LuZening/OPA1000/reference/pc-board-rf-deck.jpg

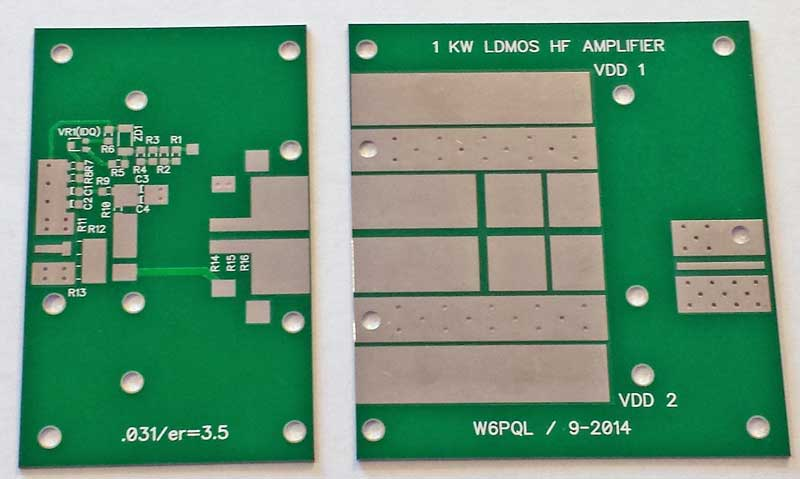
reference/pc-board-rf-deck.jpg
