LuZening/OPA1000/reference/52017sch.jpg

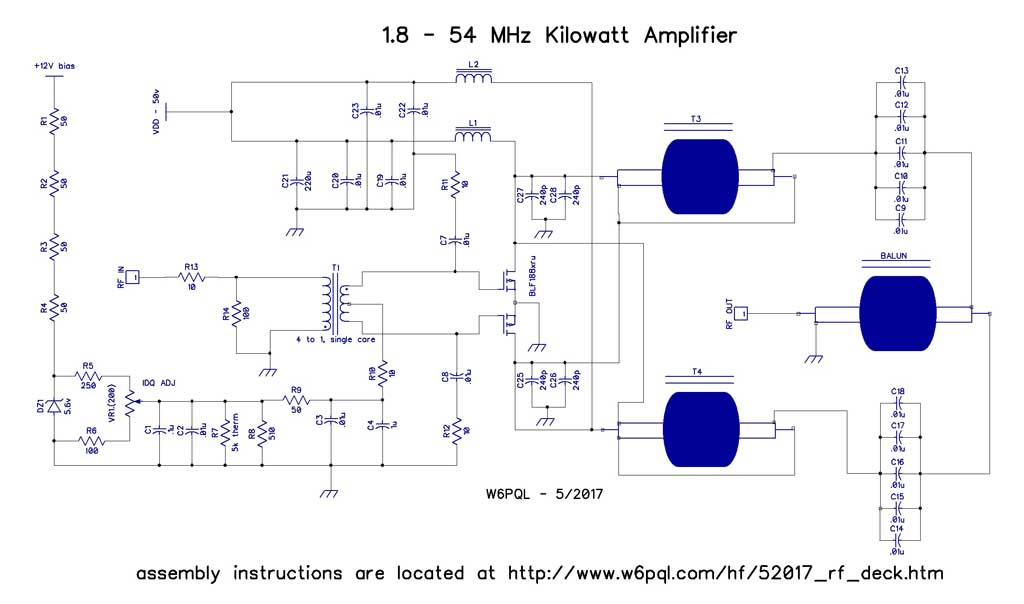
reference/52017sch.jpg
