LuZening/OPA1000/reference/201706schematic.jpg

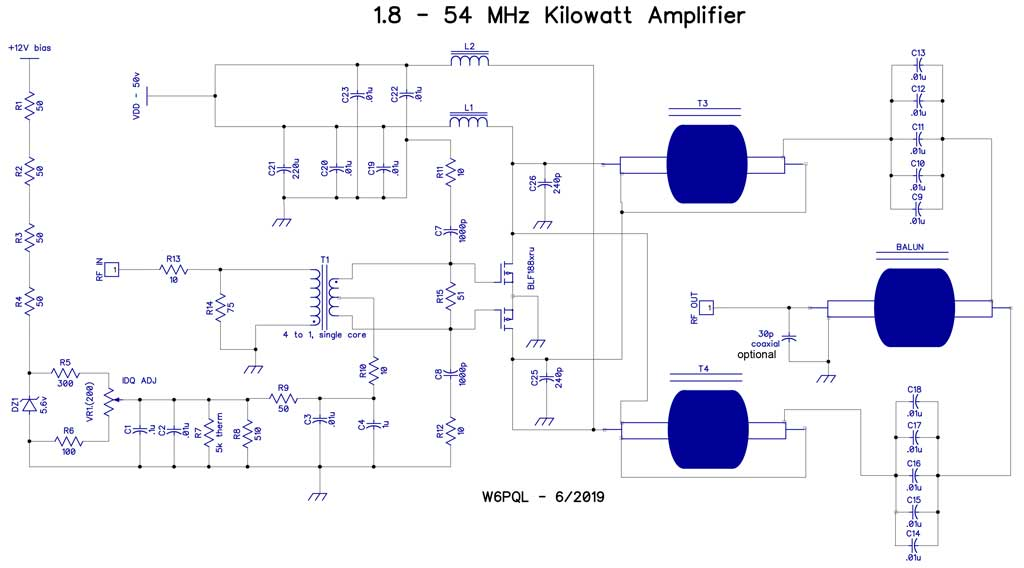
reference/201706schematic.jpg
