LuZening/OPA1000/reference/CAN.png

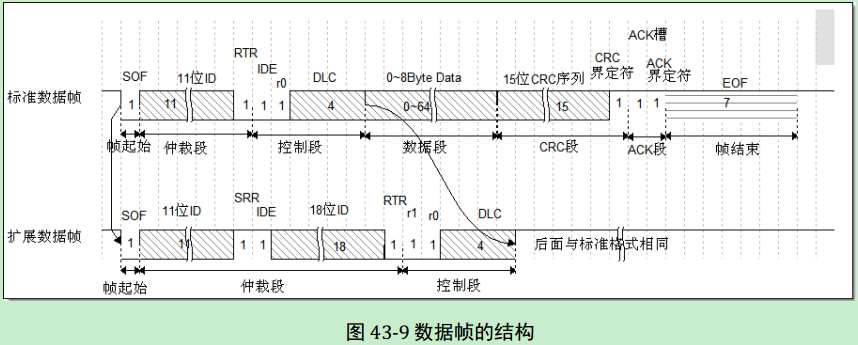
reference/CAN.png
