LuZening/OPA1000/reference/LCD/TB23FU7acbI8KJjy1zdXXbe1VXa_!!23732491.jpg

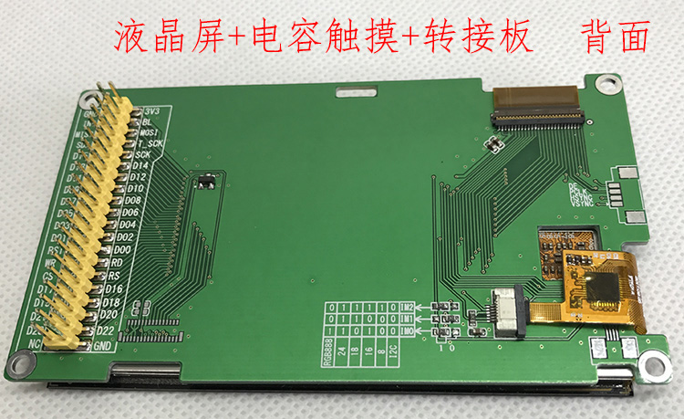
reference/LCD/TB23FU7acbI8KJjy1zdXXbe1VXa_!!23732491.jpg
