LuZening/OPA1000/reference/power.png

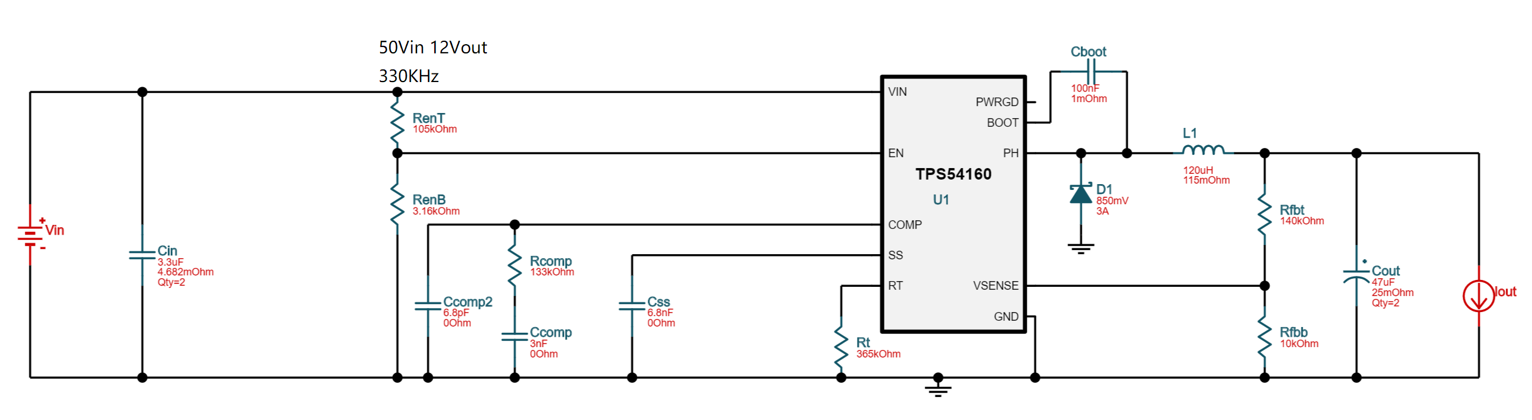
reference/power.png
