LuZening/OPA1000/reference/STM32CAN.png

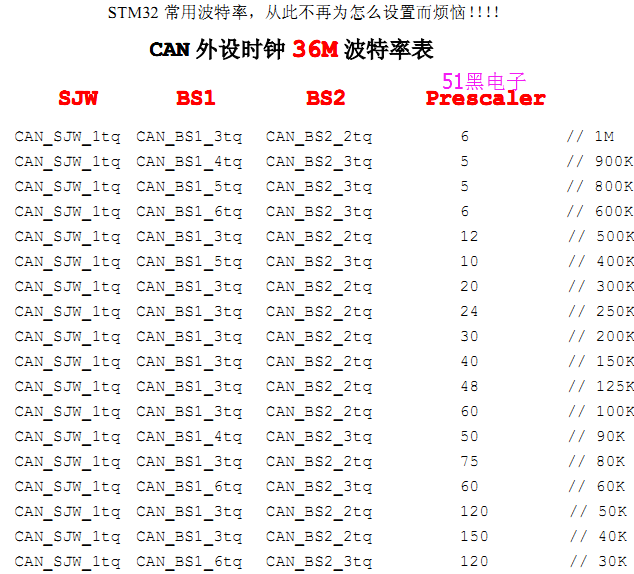
reference/STM32CAN.png
