LuZening/OPA1000/reference/T106-2.jpg

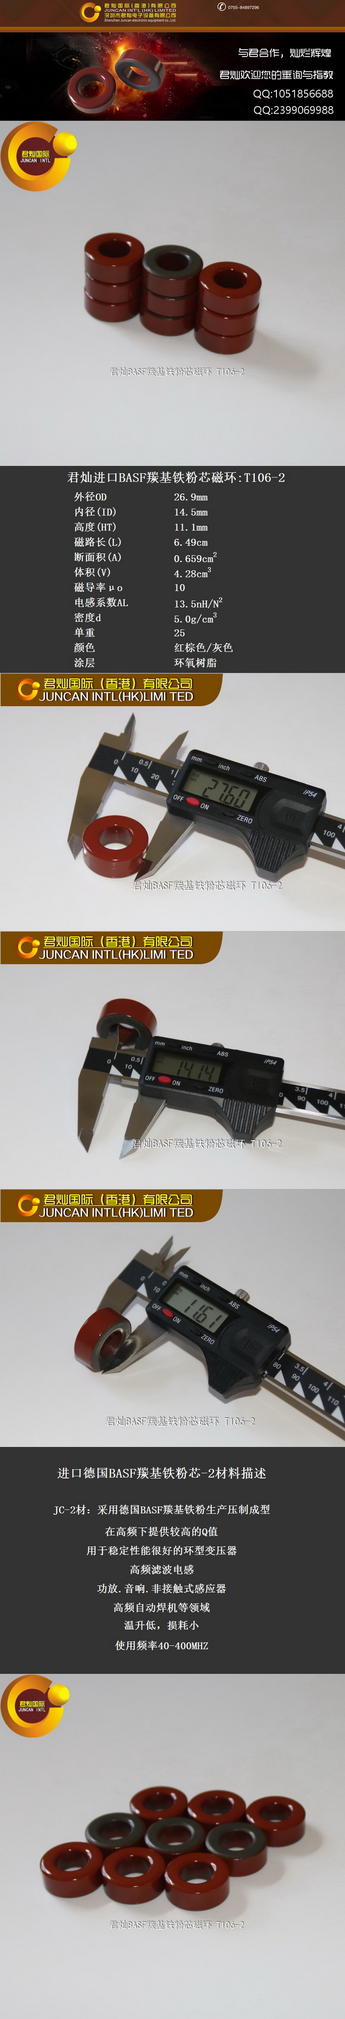
reference/T106-2.jpg
