LuZening/OPA1000/reference/T106-6.png

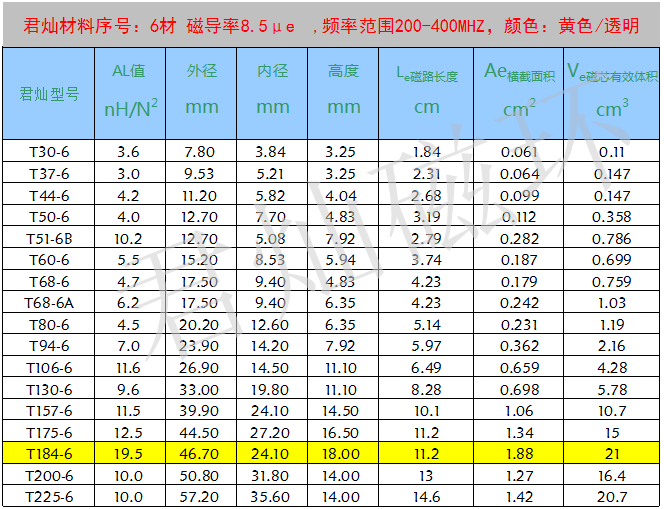
reference/T106-6.png
