LuZening/OPA1000/reference/T130-2.jpg

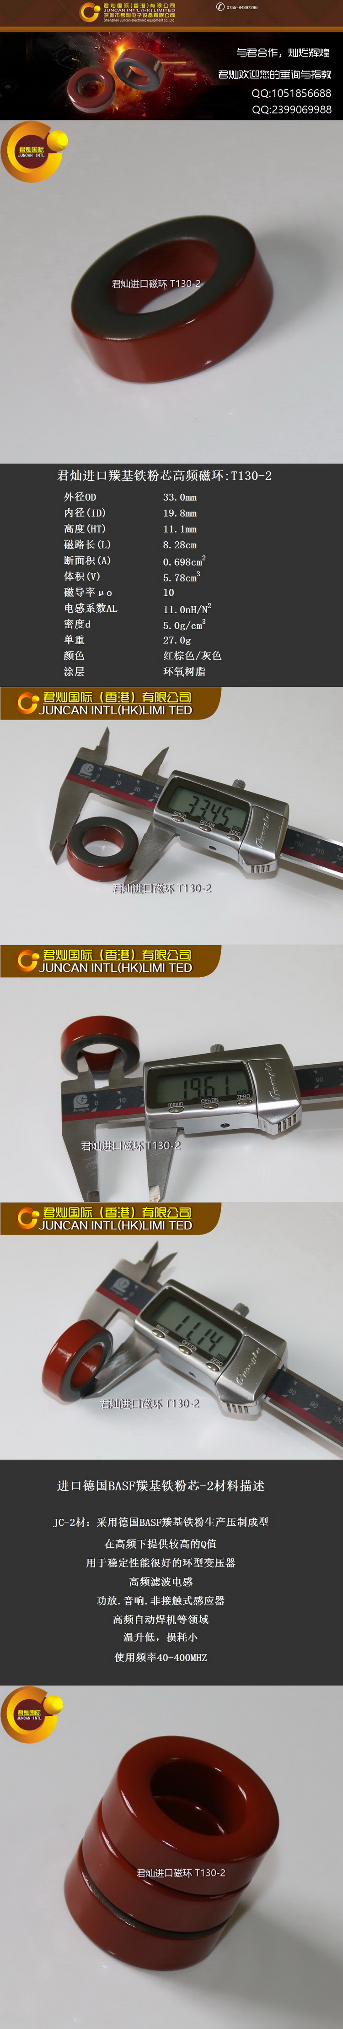
reference/T130-2.jpg
