LuZening/OPA1000/LPF/T106.dxf

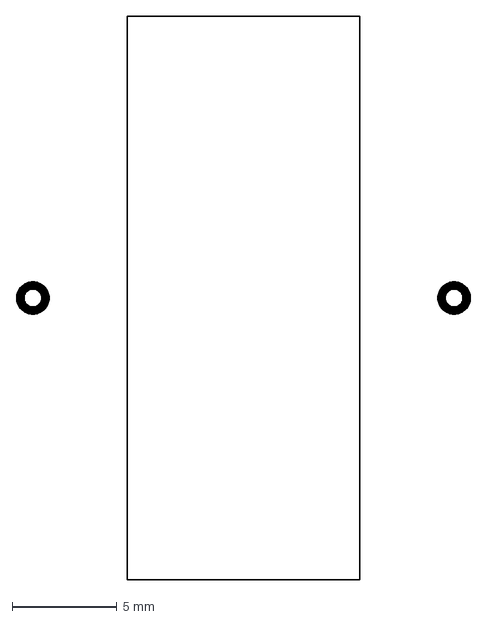
[picture p32: CAD file, 2020-02-08]
LPF/T106.dxf
21.7 x 26.9 mm
