LuZening/OPA1000/RF/BLF188XR.dxf

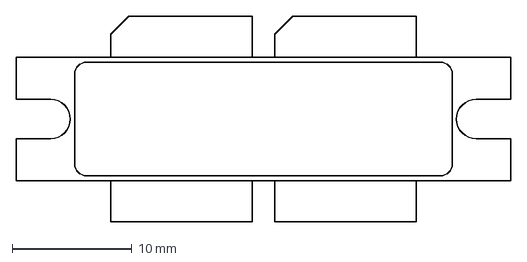
[picture p33: CAD file, 2019-12-12]
RF/BLF188XR.dxf
41.3 x 17.1 mm
