LuZening/OPA1000/(list of files, cad)

Other CAD files:
RF/drill.dwg
RF/BLF188XR.dwg
