LuZening/OPA1000/RF/OPA1000_RF/drill.pdf

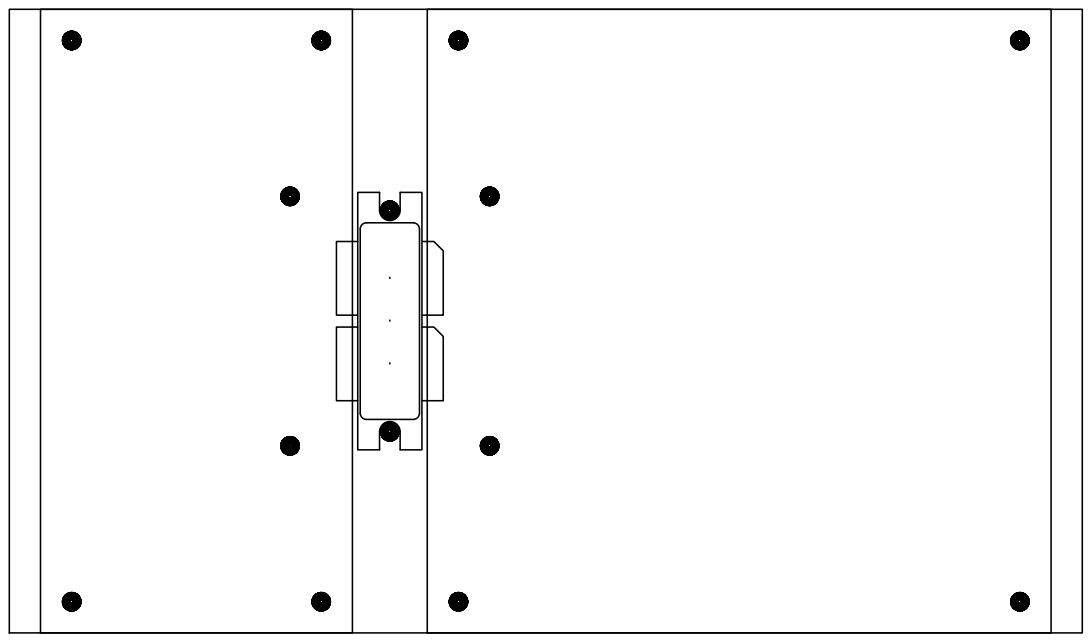
[picture p34: page 1]
