LuZening/OPA1000/(list of files, drawings)

Other design files:
reference/LCD/4.0寸_TK040及31pin.PrjPCB
reference/LCD/4.0寸_TK040及31pin.SchDoc
reference/LCD/TK040F1532转接板原理图及PCB/4.0寸_TK040及31pin.PrjPCB
reference/LCD/TK040F1532转接板原理图及PCB/4.0寸_TK040及31pin.SchDoc
