LuZening/OPA1000/Power/power.kicad_pcb

## KiCad design Power/power.kicad_pcb (2020-02-26)

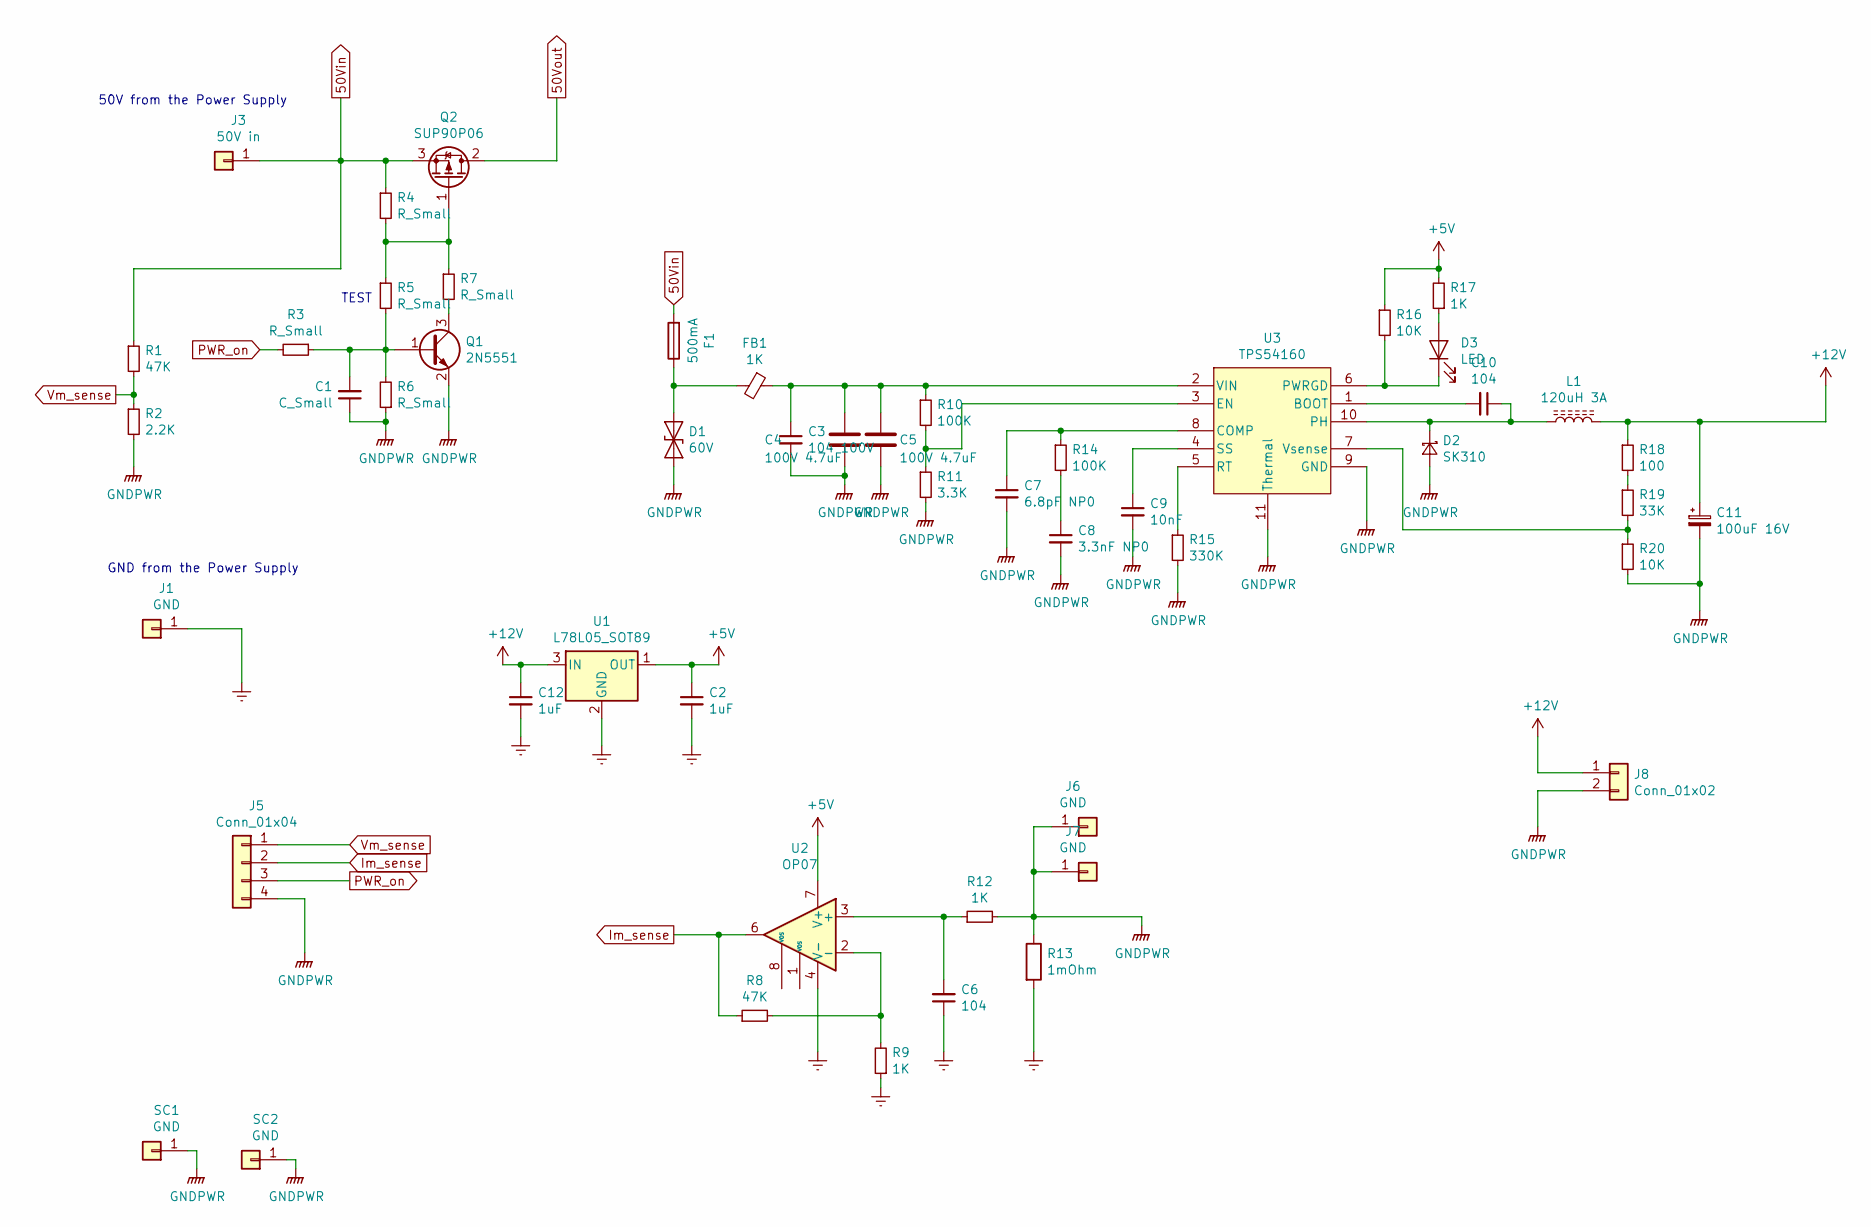
[picture p43: schematic power.sch]

Parts:
C1: C_Small; C_0805
C2, C12: 1uF; C_0805
C3: 104 100V; C_1206
C4, C5: 100V 4.7uF; C_1210
C6, C10: 104; C_0805
C7: 6.8pF NP0; C_0805
C8: 3.3nF NP0; C_0805
C9: 10nF; C_0805
C11: 100uF 16V; CP_Elec_6.3x5.8
D1: 60V; SMB(DO-214AA)_S5
D2: SK310; SMC(DO-214AB)_S1
D3: LED; LED_0805
F1: 500mA; R_1206
FB1: 1K; R_1206
J1, J6, J7: GND; PCB-10B-M4
J3: 50V in; PCB-10B-M4
J5: Conn_01x04; JST_XH_B04B-XH-A_04x2.50mm_Straight
J8: Conn_01x02; 508CON-2P
L1: 120uH 3A; L_12.6mm_13.5mm
Q1: 2N5551; SOT-23(SOT-23-3)
Q2: SUP90P06; TO-220-External_Thermal_Mount
R1, R8: 47K; R_0805
R2: 2.2K; R_0805
R3, R4, R5, R6, R7: R_Small; R_0805
R9, R12, R17: 1K; R_0805
R10, R14: 100K; R_0805
R11: 3.3K; R_0805
R13: 1mOhm; 5930
R15: 330K; R_0805
R16, R20: 10K; R_0805
R18: 100; R_0805
R19: 33K; R_0805
SC1, SC2: GND; M3_Screwhole
U1: L78L05_SOT89; SOT-89(SOT-89-3)
U2: OP07; SOIC-8_150MIL
U3: TPS54160; MSOP-10-1EP_W3mm

Connections:
50Vin: F1.2, J3.1, Q2.3 (S), R1.1, R4.1
50Vout: Q2.2 (D)
+5V: C2.1, R16.1, R17.2, U1.1 (OUT), U2.7 (V+)
+12V: C11.1, C12.1, J8.1, L1.2, R18.1, U1.3 (IN)
Earth: C2.2, C6.1, C12.2, J1.1, R9.1, R13.2, U1.2 (GND), U2.4 (V-)
GNDPWR: C1.1, C3.2, C4.2, C5.2, C7.2, C8.2, C9.2, C11.2, D1.2 (A2), D2.1 (A), J5.4, J6.1, J7.1, J8.2, Q1.2 (E), R2.2, R6.1, R11.2, R12.2, R13.1, R15.2, R20.2, SC1.1, SC2.1, U3.9 (GND), U3.11 (Thermal)
Im_sense: J5.2, R8.1, U2.6
unnamed: C1.2, Q1.1 (B), R3.1, R5.2, R6.2
unnamed: C3.1, C4.1, C5.1, FB1.1, R10.1, U3.2 (VIN)
unnamed: C6.2, R12.1, U2.3 (+)
unnamed: C7.1, R14.1, U3.8 (COMP)
unnamed: C8.1, R14.2
unnamed: C9.1, U3.4 (SS)
unnamed: C10.1, D2.2 (K), L1.1, U3.10 (PH)
unnamed: C10.2, U3.1 (BOOT)
unnamed: D1.1 (A1), F1.1, FB1.2
unnamed: D3.1 (K), R16.2, U3.6 (PWRGD)
unnamed: D3.2 (A), R17.1
unnamed: Q1.3 (C), R7.2
unnamed: Q2.1 (G), R4.2, R5.1, R7.1
unnamed: R8.2, R9.2, U2.2 (-)
unnamed: R10.2, R11.1, U3.3 (EN)
unnamed: R15.1, U3.5 (RT)
unnamed: R18.2, R19.1
unnamed: R19.2, R20.1, U3.7 (Vsense)
PWR_on: J5.3, R3.2
Vm_sense: J5.1, R1.2, R2.1

Notes on the sheet:
GND from the Power Supply
50V from the Power Supply
TEST

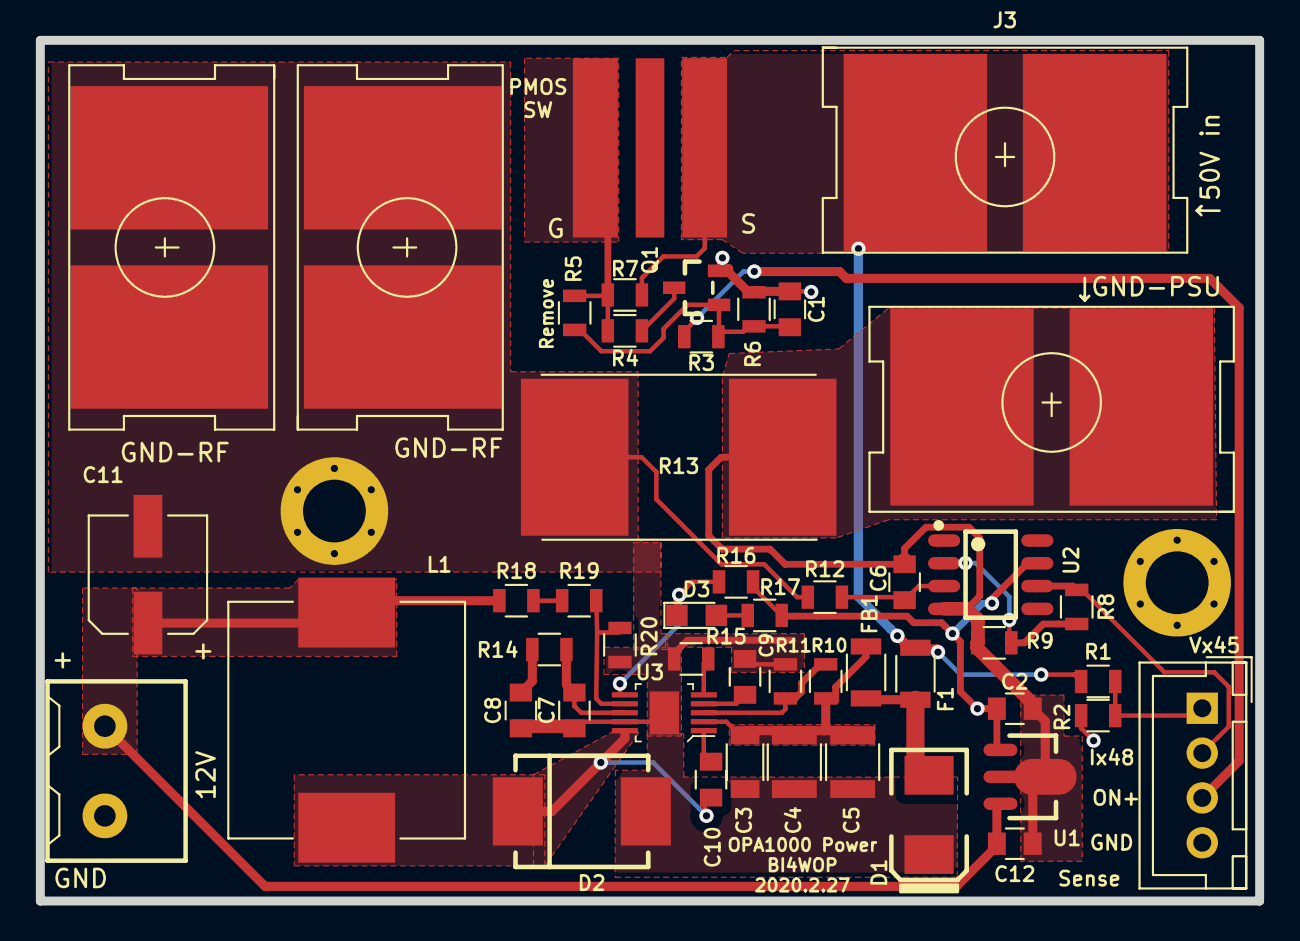
[picture p44: board power.kicad_pcb from above]

Board: 2 copper layers, 68.0 x 48.0 mm, 51 parts (0 on the bottom side), 26 nets.
