LuZening/OPA1000/RF/Directional_Coupler/Directional_coupler.kicad_pcb

## KiCad design RF/Directional_Coupler/Directional_coupler.kicad_pcb (2020-02-08)

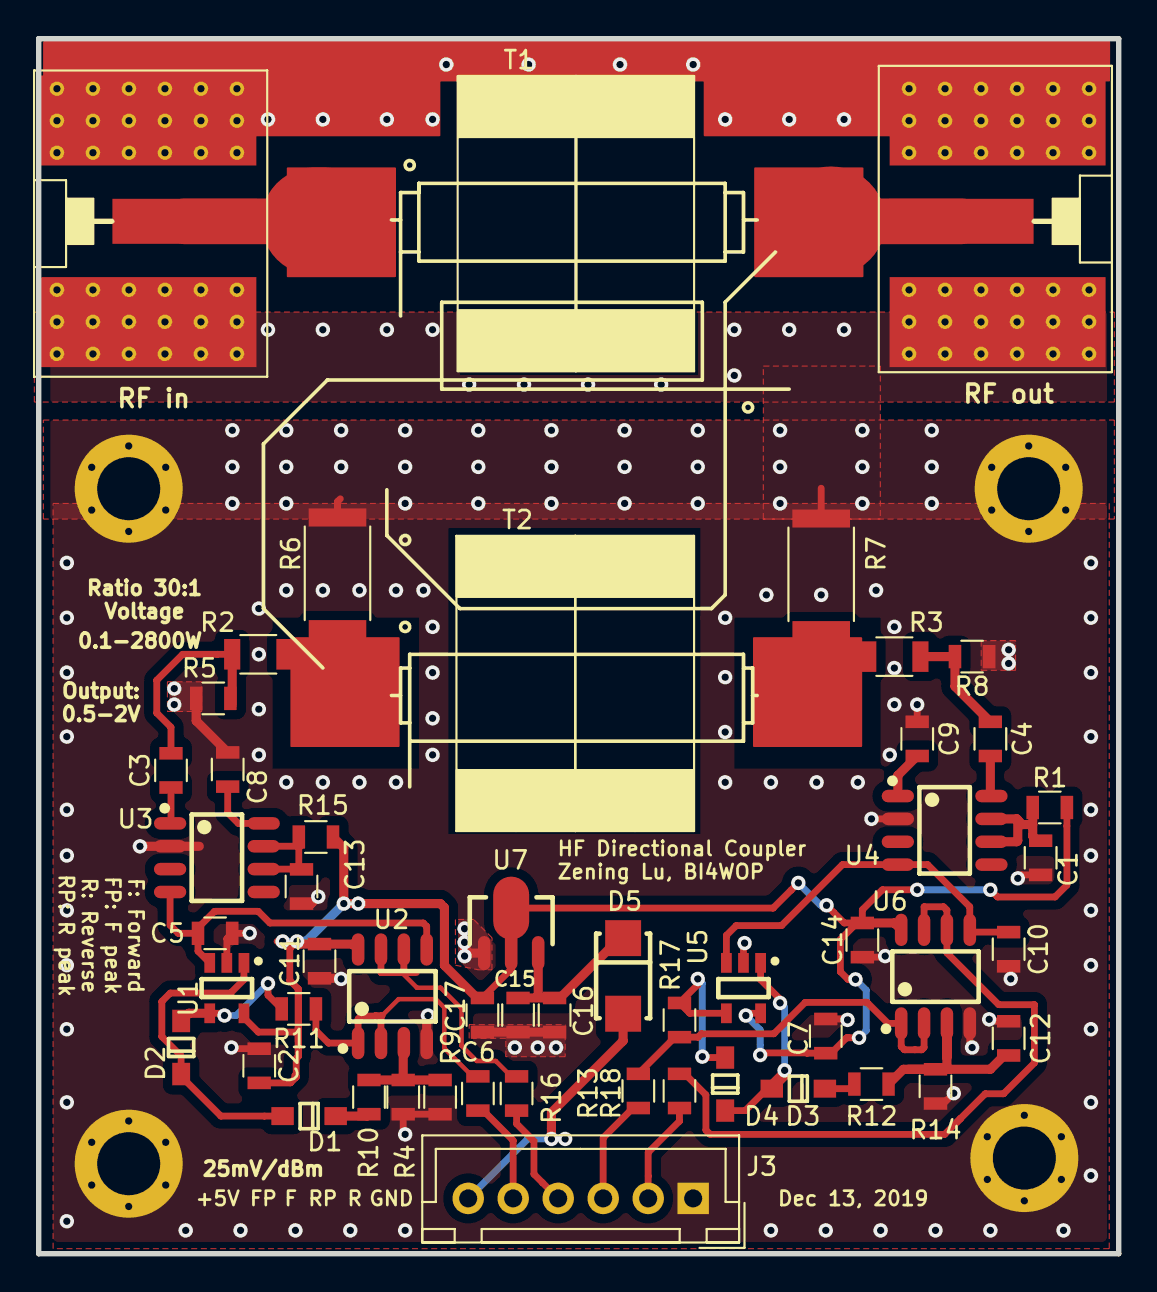
[picture p45: board Directional_coupler.kicad_pcb from above]

Board: 2 copper layers, 60.0 x 67.5 mm, 58 parts (0 on the bottom side), 32 nets.

Parts:
C1, C2, C3, C4, C5, C7, C8, C9, C10, C11, C13, C14, C15: 104; R_0805
C6, C12: 1uF; R_0805
C16, C17: 10uF; R_0805
D1, D2, D3, D4: 1N4148; SOD-123
D5: SS14; SMA(DO-214AC)_S1
J1: RF in; RF_conn_pad
J2: RF out; RF_conn_pad
J3: Singal; JST_XH_B06B-XH-A_06x2.50mm_Straight
R1, R15: 10; R_0805
R2, R3: 430; R_1206
R4, R9, R12, R13, R16, R18: 100; R_0805
R5, R8: 68; R_0805
R6, R7: 56 2W; R_2512
R10, R14: 1M; R_0805
R11, R17: 1K; R_0805
SC1, SC2, SC3, SC4: GND; M3_Screwhole
T1, T1#2: 30T; 5943004901
T2, T2#2: 1T; 5943004901
U1, U5: LMH6609MF; SOT-23-5
U2, U6: LMV358; SOIC-8_150MIL
U3, U4: AD8307; SOIC-8_150MIL
U7: AMS1117-3.3; SOT-89(SOT-89-3)

Connections:
+3V3: C2.2, C7.2, C11.2, C14.2, C17.1, R1.1, R15.1, U1.5, U2.8, U5.5, U6.8, U7.2
+5V: D5.1, J3.6
FWD: J3.4, R16.1
FWD_peak: J3.5, R9.1
GND: C1.1, C2.1, C5.2, C6.2, C7.1, C8.1, C9.2, C10.2, C11.1, C12.2, C13.1, C14.1, C15.1, C16.2, C17.2, J1.2, J2.2, J3.1, R5.1, R6.2, R7.2, R8.1, R10.1, R14.1, SC1.1, SC2.1, SC3.1, SC4.1, U1.2, U2.4, U3.2, U4.2, U5.2, U6.4, U7.1
unnamed: C1.2, R1.2, U4.6, U4.7
unnamed: C3.1, R2.2, R5.2
unnamed: C3.2, U3.1
unnamed: C4.1, U4.8
unnamed: C4.2, R3.1, R8.2
unnamed: C5.1, U1.3, U2.5, U3.4
unnamed: C6.1, R4.1, R10.2, U2.3
unnamed: C8.2, U3.8
unnamed: C9.1, U4.1
unnamed: C10.1, U4.4, U5.3, U6.5
unnamed: C12.1, R12.2, R14.2, U6.3
unnamed: C13.2, R15.2, U3.6, U3.7
unnamed: C15.2, C16.1, D5.2, U7.3
unnamed: D1.1, D2.2, U1.1
unnamed: D1.2, R4.2
unnamed: D2.1, R11.2, U1.4
unnamed: D3.1, D4.2, U5.1
unnamed: D3.2, R12.1
unnamed: D4.1, R17.1, U5.4
unnamed: R2.1, R6.1
unnamed: R3.2, R7.1
unnamed: R9.2, R11.1, U2.1, U2.2
unnamed: R13.1, R17.2, U6.1, U6.2
unnamed: R16.2, U2.6, U2.7
unnamed: R18.1, U6.6, U6.7
REV: J3.2, R18.2
REV_peak: J3.3, R13.2
