LuZening/OPA1000/RF/OPA1000_RF/RF_input/RF_input.kicad_pcb

## KiCad design RF/OPA1000_RF/RF_input/RF_input.kicad_pcb (2019-12-12)

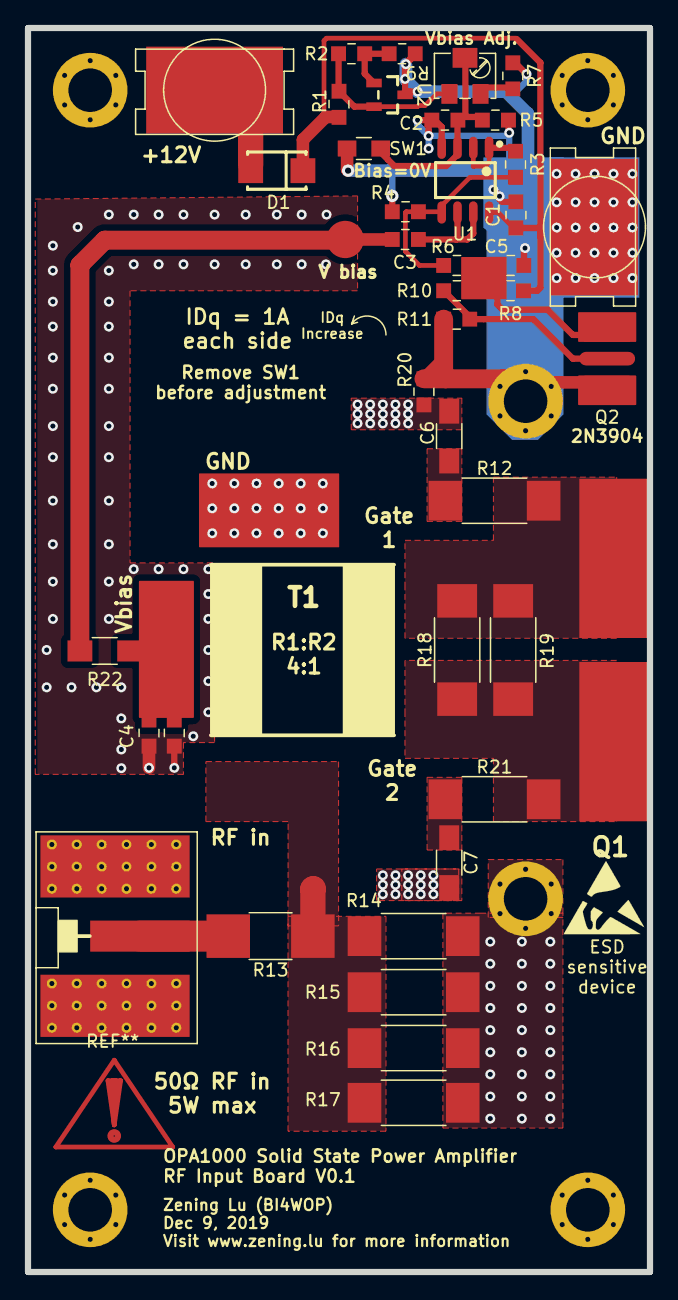
[picture p46: board RF_input.kicad_pcb from above]

Board: 2 copper layers, 50.0 x 100.0 mm, 48 parts (0 on the bottom side), 21 nets.

Parts:
C1, C2, C3, C4, C4#2, C5: 104; 0805
C6, C7: 102; C_1206_HandSoldering
D1: 1N4007; SMA(DO-214AC)_S1
J1: +12V; PCB-35-M3
J2: GND; PCB-35-M3
J3: In; RF_conn_pad
Q1: BLF188XR
Q2: 2N3904; TO-92-SMD
R1: 2.2K; 0805
R2: 200; 0805
R3: 2K; 0805
R4: 10; 0805
R5: 220k; 0805
R6: 8.2K; 0805
R7: 1k; 0805
R8: 1.8K; 0805
R9: 10K; 0805
R10: 5.6K; 0805
R11: 1K; 0805
R12, R21: 10 1W; R_2512_HandSoldering
R13: 22 1/2W; R_1812_HandSoldering
R14, R15, R16, R17: 240 1W; R_2512_HandSoldering
R18, R19: 100 1W; R_2512_HandSoldering
R20: 0; 0805
R22: 0; R_1206_HandSoldering
RV1: 2.2k; Potentiometer_Trimmer_Bourns_3224W
SC1, SC2, SC3, SC4, SC5, SC6: Screw; M3_Screwhole
SW1: SW_SPDT; R_0805_HandSoldering
T1: 28B0562-100
TP1: TestPoint; Measurement_Point_Round-SMD-Pad_Big
U1: LM358; SOIC-8_150MIL
U2: TL431; SOT-23(SOT-23-3)

Connections:
+12V: C1.1, D1.2, R1.2, R8.1, U1.8
/K: R1.1, R2.1, RV1.1, U2.2
G1: Q1.3, R12.2, R18.2, R19.2
G2: Q1.4, R18.1, R19.1, R21.2
GND: C1.2, C2.2, C3.2, C5.2, J2.1, Q2.1, R5.2, R7.2, R9.2, R11.2, R20.1, SC1.1, SW1.2, U1.4, U2.3
GNDPWR: C4.2, C4#2.2, C6.2, C7.2, J3.2, R14.1, R15.1, R16.1, R17.1, R20.2, SC2.1, SC3.1, SC4.1, SC5.1, SC6.1
unnamed: C2.1, R5.1, RV1.2, SW1.1, U1.3
unnamed: C3.1, R3.1, R6.2, U1.5
unnamed: C4.1, C4#2.1, R22.2
unnamed: C5.1, Q2.3, R6.1, R8.2, R10.1
unnamed: C6.1, R12.1
unnamed: C7.1, R21.1
unnamed: D1.1, J1.1
unnamed: J3.1, R13.2
unnamed: Q2.2, R10.2, R11.1
unnamed: R2.2, R9.1, U2.1
unnamed: R3.2, U1.1, U1.2
unnamed: R4.2, U1.6, U1.7
unnamed: R7.1, RV1.3
unnamed: R13.1, R14.2, R15.2, R16.2, R17.2
Vbias: R4.1, R22.1, TP1.1
