LuZening/OPA1000/RF/OPA1000_RF/RF_output/RF_output.kicad_pcb

## KiCad design RF/OPA1000_RF/RF_output/RF_output.kicad_pcb (2019-12-12)

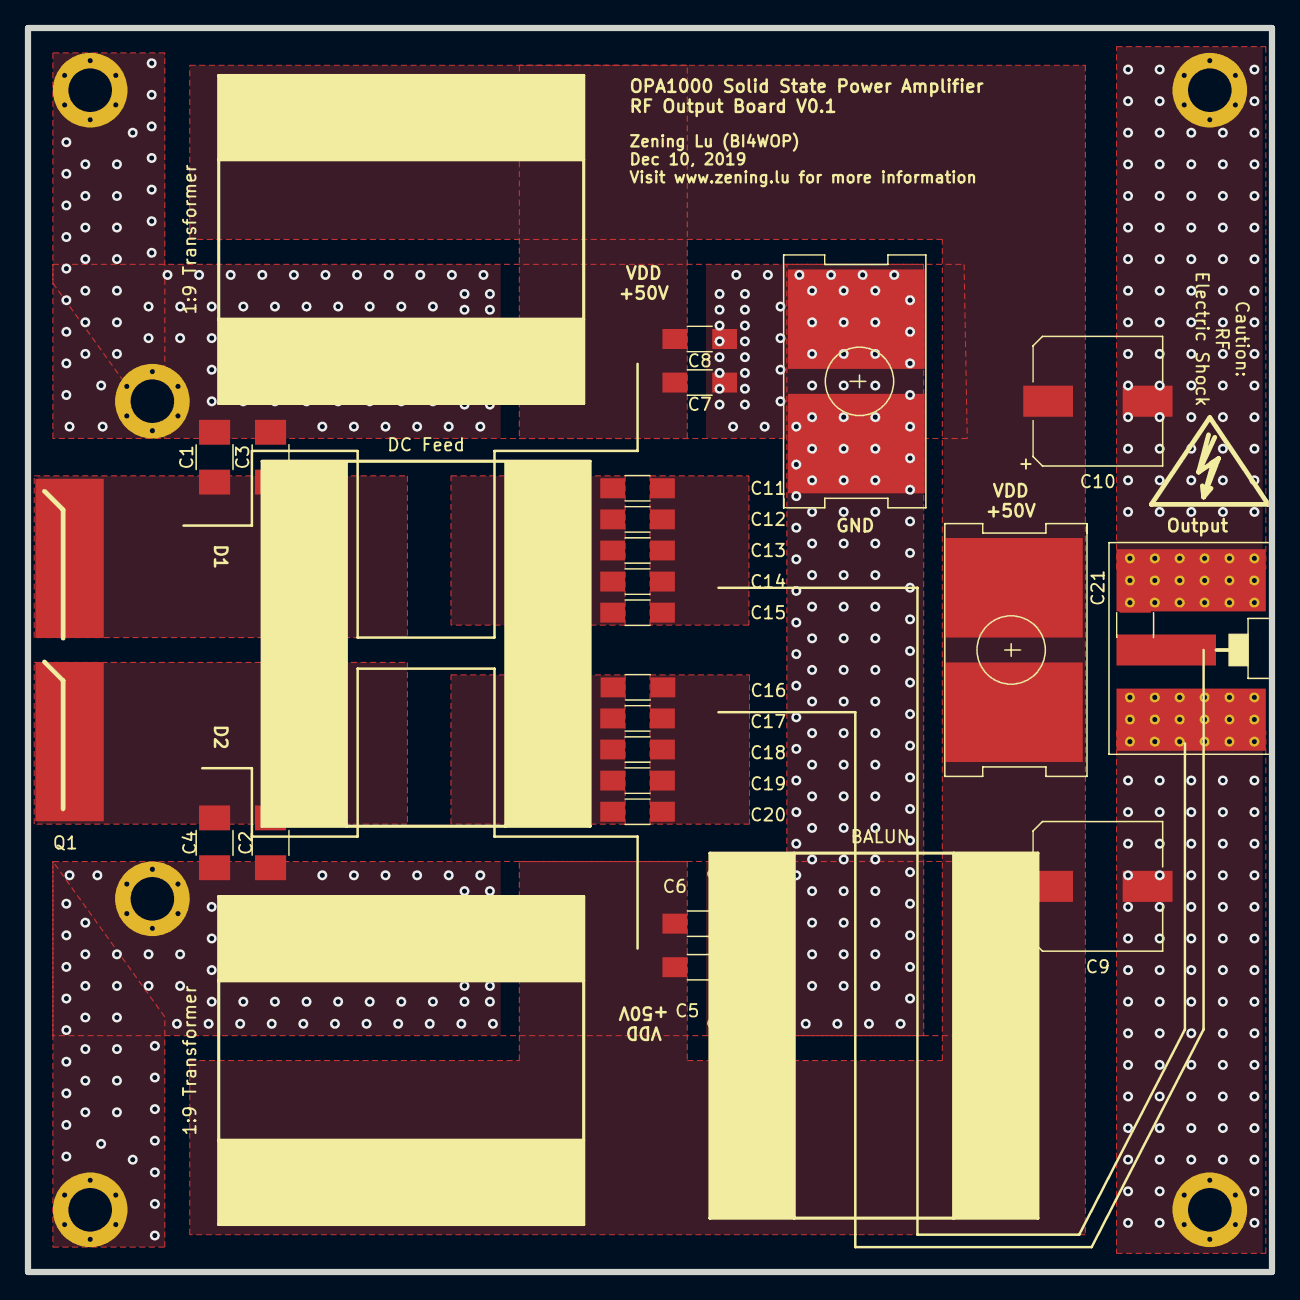
[picture p47: board RF_output.kicad_pcb from above]

Board: 2 copper layers, 100.0 x 100.0 mm, 36 parts (0 on the bottom side), 9 nets, no tracks yet.

Parts:
1:9 Transformer, 1:9 Transformer#2: Laird_28B1020_100
BALUN: Laird_28B1020_100
C1, C2, C3, C4: 120pF; C_1210_HandSoldering
C5, C6, C7, C8, C11, C12, C13, C14, C15, C16, C17, C18, C19, C20: 103; C_1206_HandSoldering
C9, C10: 220uF 100V; CP_Elec_10x10.5
C21: 30pF; C_1210_HandSoldering
DC Feed: Laird_28B1020_100
J1: Conn_Coaxial; RF_conn_pad
J2: VDD in; PCB-10B-M4
J3: GND; PCB-10B-M4
Q1: BLF188XR
SC1, SC2, SC3, SC4, SC5, SC6: GND; M3_Screwhole
SYM1: Symbol_HighVoltage_Type2_SilkTop_VerySmall

Connections:
D1: C1.1, C3.1, Q1.1
D2: C2.1, C4.1, Q1.2
GNDPWR: C1.2, C2.2, C3.2, C4.2, C5.1, C6.1, C7.1, C8.1, C9.2, C10.2, C21.2, J1.2, J3.1, SC1.1, SC2.1, SC3.1, SC4.1, SC5.1, SC6.1
unnamed: C11.1, C12.1, C13.1, C14.1, C15.1
unnamed: C11.2, C12.2, C13.2, C14.2, C15.2
unnamed: C16.1, C17.1, C18.1, C19.1, C20.1
unnamed: C16.2, C17.2, C18.2, C19.2, C20.2
unnamed: C21.1, J1.1
VDD: C5.2, C6.2, C7.2, C8.2, C9.1, C10.1, J2.1
