LuZening/OPA1000/Code/OPA1000_controller.ioc

Mcu.UserName=STM32F407VETx
PA0-WKUP.Signal=ADCx_IN0
PA1.Signal=ADCx_IN1
PA10.Signal=USART1_RX
PA13.Signal=GPIO_Input
PA14.Signal=GPIO_Input
PA15.Signal=GPIO_Input
PA2.Signal=USART2_TX
PA3.Signal=ADCx_IN3
PA4.Signal=ADCx_IN4
PA5.Signal=ADCx_IN5
PA6.Signal=ADCx_IN6
PA7.Signal=ADCx_IN7
PA9.Signal=USART1_TX
PB0.Signal=ADCx_IN8
PB1.Signal=ADCx_IN9
PB11.Signal=GPXTI11
PB12.Signal=CAN2_RX
PB13.Signal=CAN2_TX
PB3.Signal=SPI1_SCK
PB4.Signal=SPI1_MISO
PB5.Signal=SPI1_MOSI
PC0.Signal=ADCx_IN10
PC1.Signal=ADCx_IN11
PC10.Signal=GPIO_Input
PC11.Signal=GPIO_Input
PC12.Signal=GPIO_Input
PC13-ANTI_TAMP.Signal=GPIO_Output
PC14-OSC32_IN.Signal=GPIO_Input
PC2.Signal=ADCx_IN12
PC3.Signal=ADCx_IN13
PC4.Signal=ADCx_IN14
PD0.Signal=FSMC_D2
PD1.Signal=FSMC_D3
PD10.Signal=FSMC_D15
PD13.Signal=FSMC_A18
PD14.Signal=FSMC_D0
PD15.Signal=FSMC_D1
PD4.Signal=FSMC_NOE
PD5.Signal=FSMC_NWE
PD6.Signal=USART2_RX
PD7.Signal=FSMC_NE1
PD8.Signal=FSMC_D13
PD9.Signal=FSMC_D14
PE10.Signal=FSMC_D7
PE11.Signal=FSMC_D8
PE12.Signal=FSMC_D9
PE13.Signal=FSMC_D10
PE14.Signal=FSMC_D11
PE15.Signal=FSMC_D12
PE2.Signal=GPIO_Output
PE3.Signal=GPIO_Output
PE4.Signal=GPIO_Output
PE5.Signal=GPIO_Output
PE6.Signal=GPIO_Output
PE7.Signal=FSMC_D4
PE8.Signal=FSMC_D5
PE9.Signal=FSMC_D6
PH0-OSC_IN.Signal=RCC_OSC_IN
PH1-OSC_OUT.Signal=RCC_OSC_OUT
