LuZening/OPA1000/reference/AMP_BLF188XR_V1p02/AMP_BLF188XR_V1p02/eesof_lib.cfg

DESIGN_KIT_NAME=AMP_BLF188XR_V1p02
DESIGN_KIT_ROOT=../
VERSION=V1p02
BOOT_AEL=../de/ael/boot
VERILOGA_DIRECTORY=../bin_2016_01
INPUT_DATA_PATH=../circuit/data;../circuit/models
ADSLIBCONFIG_DIRECTORY=../circuit/config
TEMPLATES_DIRECTORY=../circuit/templates/library
DDS_TEMPLATES_DIRECTORY=../circuit/templates
LIB_BROWSER_CTL=../circuit/records/AMP_BLF188XR_V1p02.ctl
LIB_BROWSER_REC_ONLY=TRUE
NETLIST_EXPORTER_DIRECTORY=../netlist_exp
EXPRESSIONS_DIRECTORY=../expressions/ael
DOC_DIRECTORY=../doc
