LuZening/OPA1000/reference/LCD/Camera and uc_gui_4.0_按键触摸混合版_图片R61408_IPS/code/ffs/beifen/Config.h

/*--------------File Info-------------------------------------------------------
** 文   件   名:  Config.h
** 最后修改日期:  2008.3.28
** 版        本:  V1.0
** 描        述:  配置文件、裁剪不需要的功能					
**------------------------------------------------------------------------------
** Created   by:    		
** Created date:			
*******************************************************************************/
#ifndef __Config_h
#define __Config_h    

#include "stm32f10x_lib.h"
#include "SD_driver.h"
//#include "ili9325.h"
#include "diskio.h"
#include "ff.h"

#endif
