LuZening/OPA1000/(commit log)

2020-02-08 Controller Circuit Done. Now routing
    [Directional_coupler-Bottom_Cu.gbl, Directional_coupler-Bottom_Mask.gbs, Directional_coupler-Bottom_Paste.gbp, Directional_coupler-Bottom_Silk.gbo, Directional_coupler-EdgeCuts.gko, Directional_coupler-NPTH.drl, Directional_coupler-PTH.drl, Directional_coupler-Top_Cu.gtl]
2020-02-13 MCU routed
    [ExternalInput.sch, MCU.kicad_pcb, MCU.sch, MonitorInput.sch, OutputSignals.sch, Power.sch]
2020-02-26 Power module
    [ExternalInput.sch, FaultHandling.sch, MCU.kicad_pcb, MCU.sch, Power.sch, power.kicad_pcb, power.sch]
