LuZening/OPA1000/(notices)

Notices in the files:
reference/LCD/Camera and uc_gui_4.0_按键触摸混合版_图片R61408_IPS/code/PS2/ps2.h:
Copyright(C) ÕýµãÔ­×Ó 2009-2019
All rights reserved
